hemart-tn/water-level-iot-esp8266/images/Auto&ManualMode.jpg

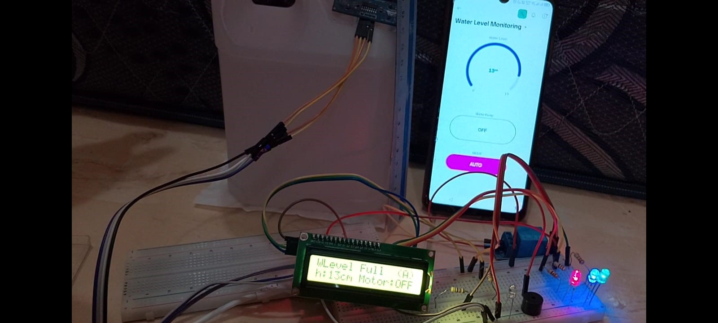
images/Auto&ManualMode.jpg
