hemart-tn/water-level-iot-esp8266/images/AutoMode.jpg

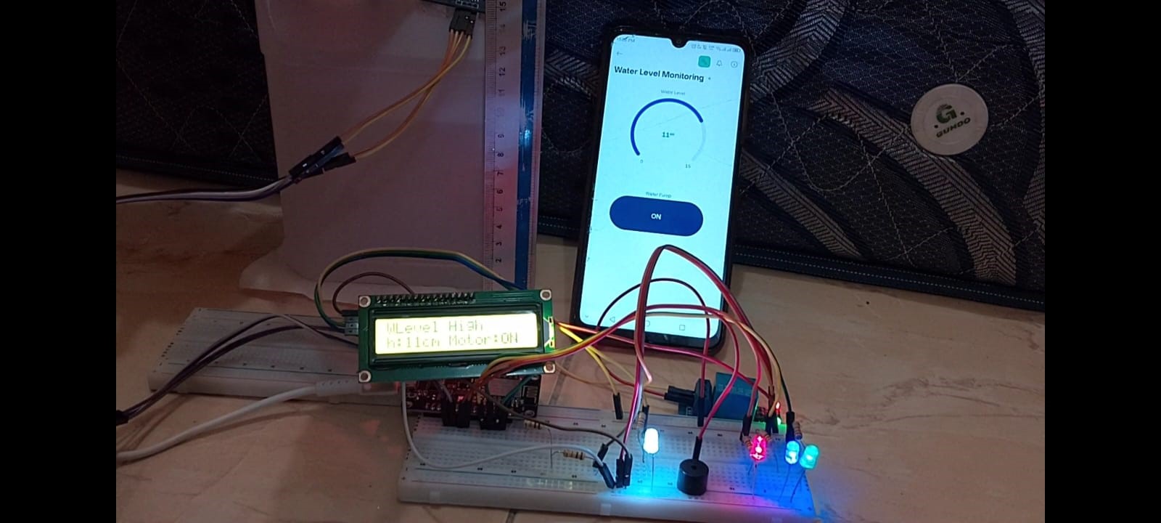
images/AutoMode.jpg
