hemart-tn/water-level-iot-esp8266/(commit log)

2026-04-03 restructure project
    [HCSR04 REGRESSION.xlsx]
2026-04-03 final rapikan struktur project
    [HCSR04 REGRESSION.xlsx]
